Rujul-Rumale/INSPACe-CanSat-Team-Tejas-PCB-Design/README.md

# Tejas CanSat — Onboard Computer (OBC) PCB

Carrier board for our INSPACe CanSat ("Tejas") — Teensy 4.1, XBee radio, and a full
sensor suite (BNO055, BME688, DPS310, INA260, MICS5524) with dual buck regulators,
servo/ESC headers, and buzzer on a ~102×102 mm 2-layer board.

Designed by me (**Rujul Rumale**) in KiCad, Oct 2025 — schematic, layout, and Gerber
release. I also put together the data-processing section of our PFR deck.

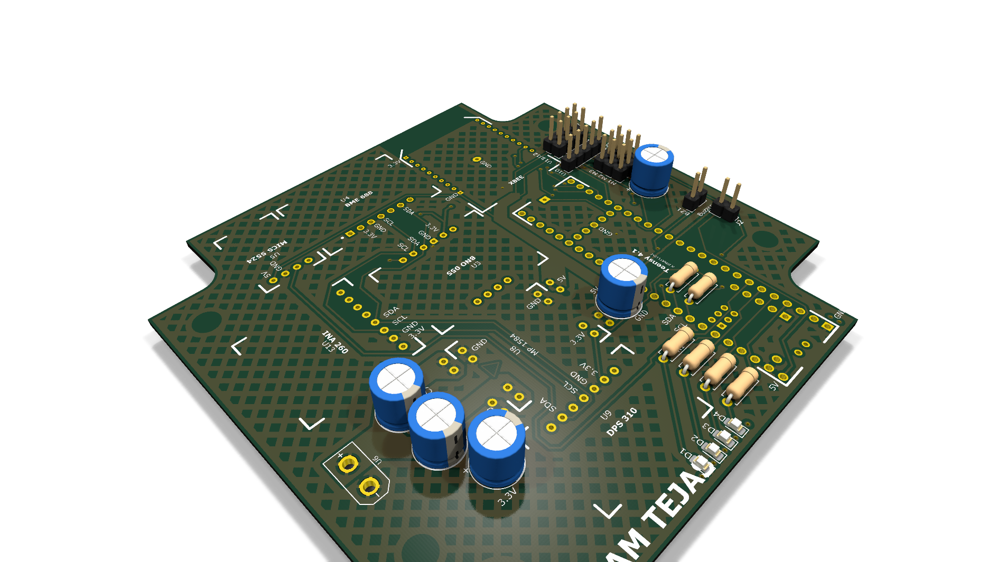
[picture p1: docs/renders/3d-iso.png]
3D isometric render


| Top | Bottom |
|---|---|
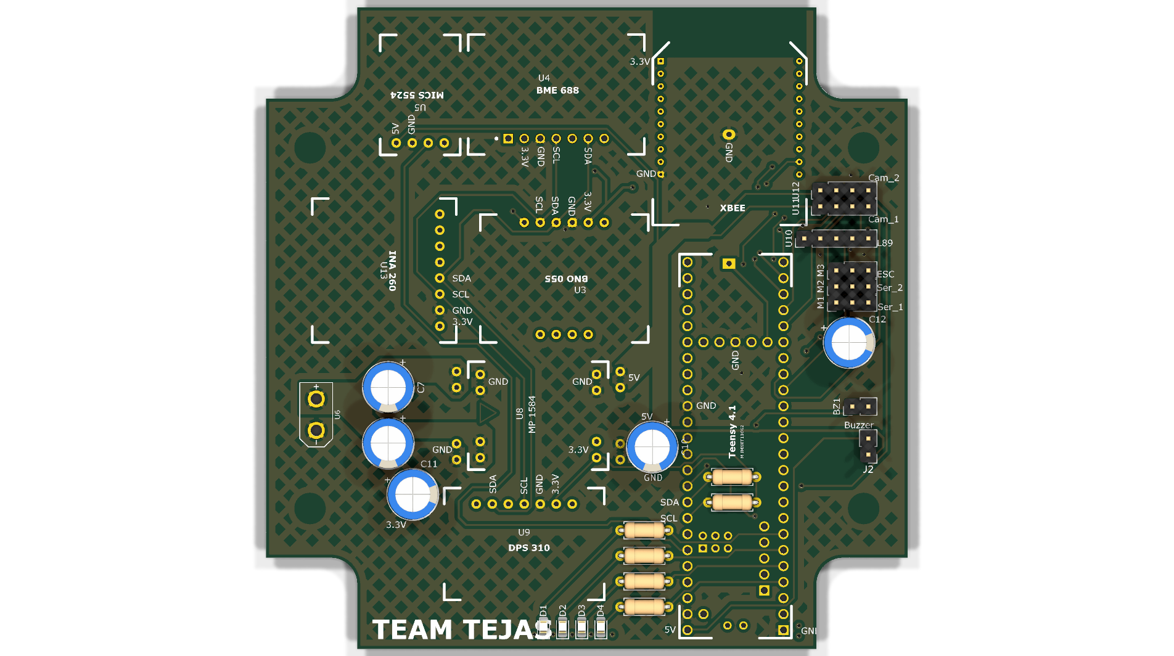
[picture p2: docs/renders/3d-top.png]
3D top
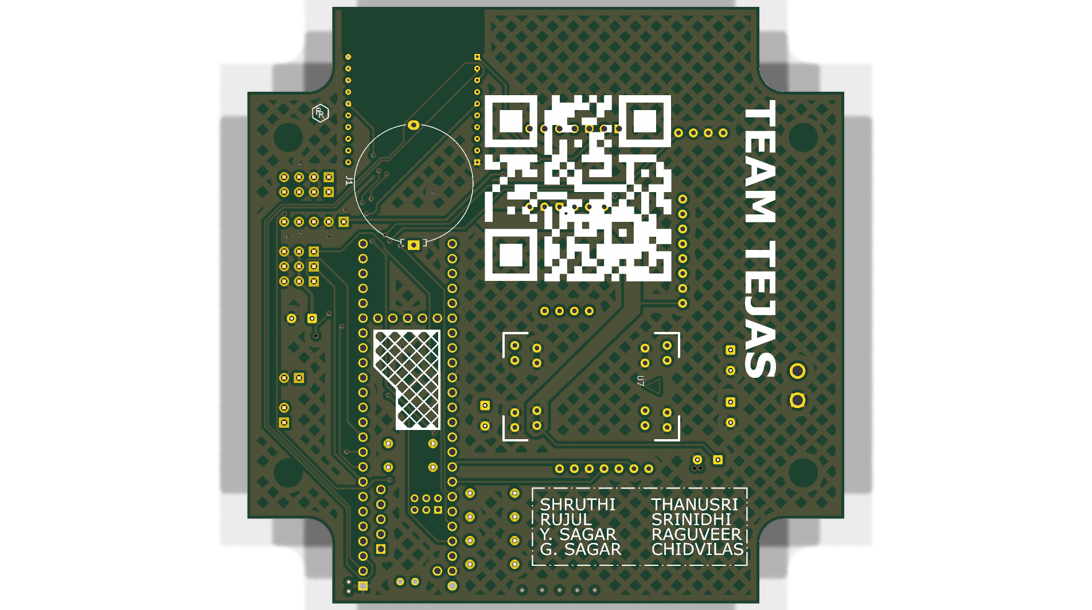
[picture p3: docs/renders/3d-bottom.png]
3D bottom
|  |  |

*Renders: KiCad raytracer. The custom module 3D bodies use absolute paths from my
old workstation, so modules show as footprints here — geometry and Gerbers are unaffected.*

## Photos — fabbed and assembled

The real thing: blue soldermask, fully populated and wired.

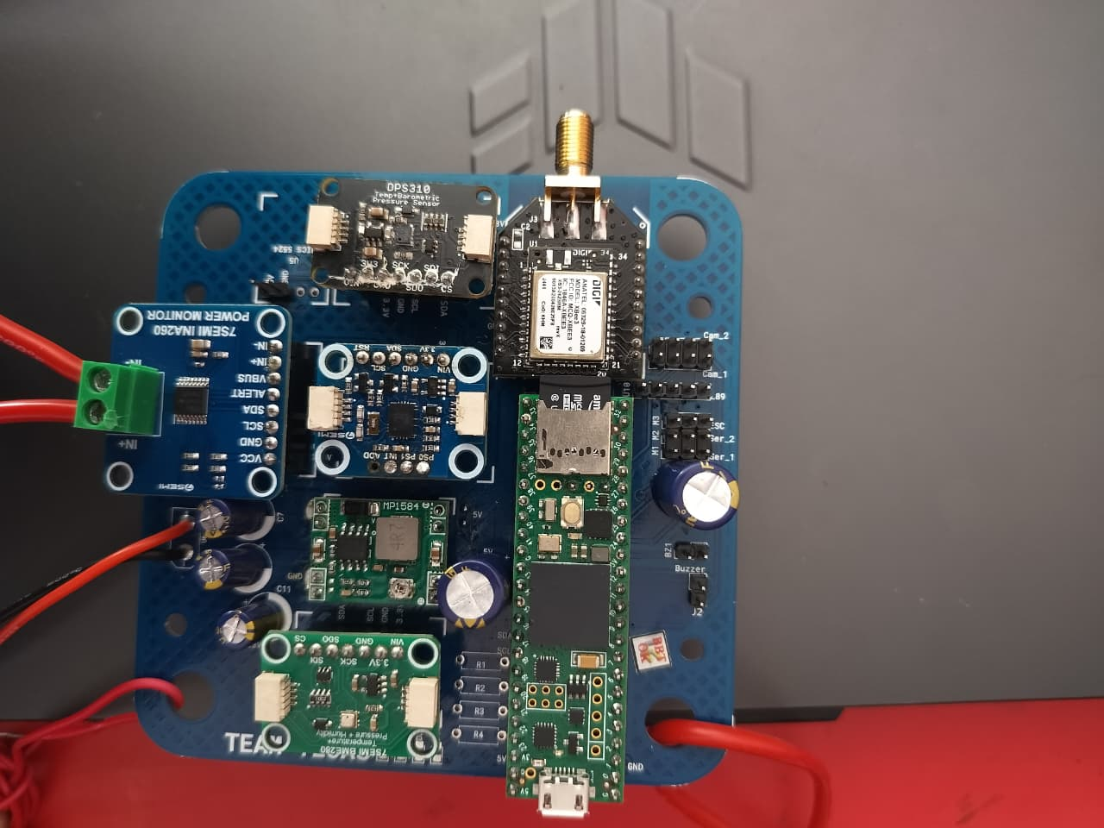
[picture p4: docs/photos/assembled-populated.jpeg]
Assembled board, populated and wired


| Bare fab — top | Bare fab — bottom |
|---|---|
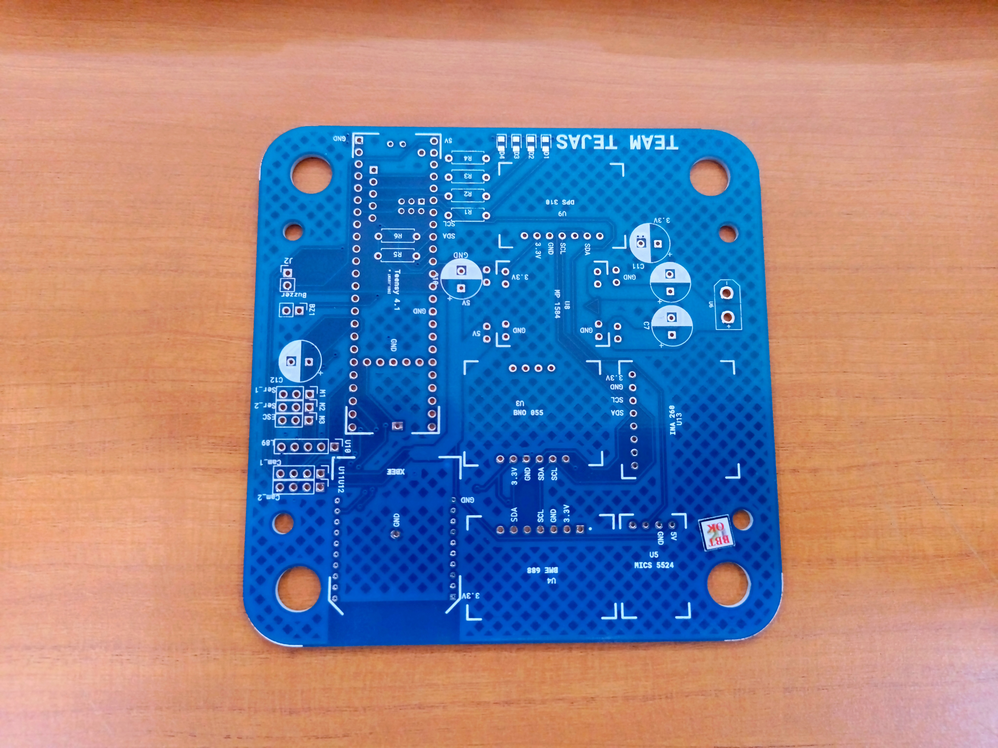
[picture p5: docs/photos/fab-top-bare.jpg]
Bare fab top
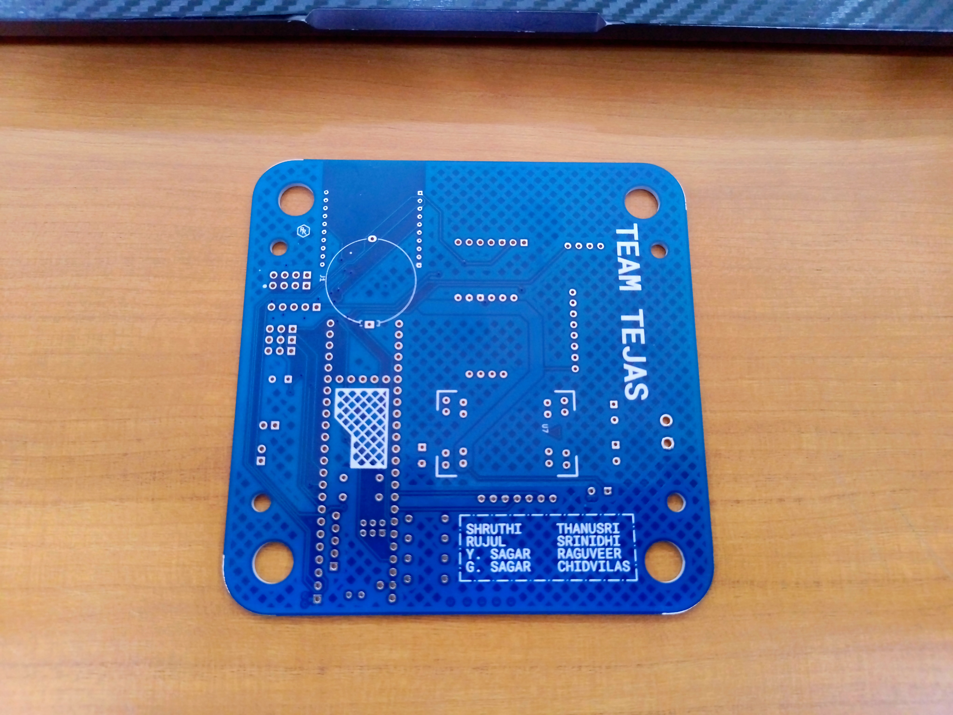
[picture p6: docs/photos/fab-bottom-bare.jpg]
Bare fab bottom
|  |  |

| 3D preview with modules — top | 3D preview with modules — bottom |
|---|---|
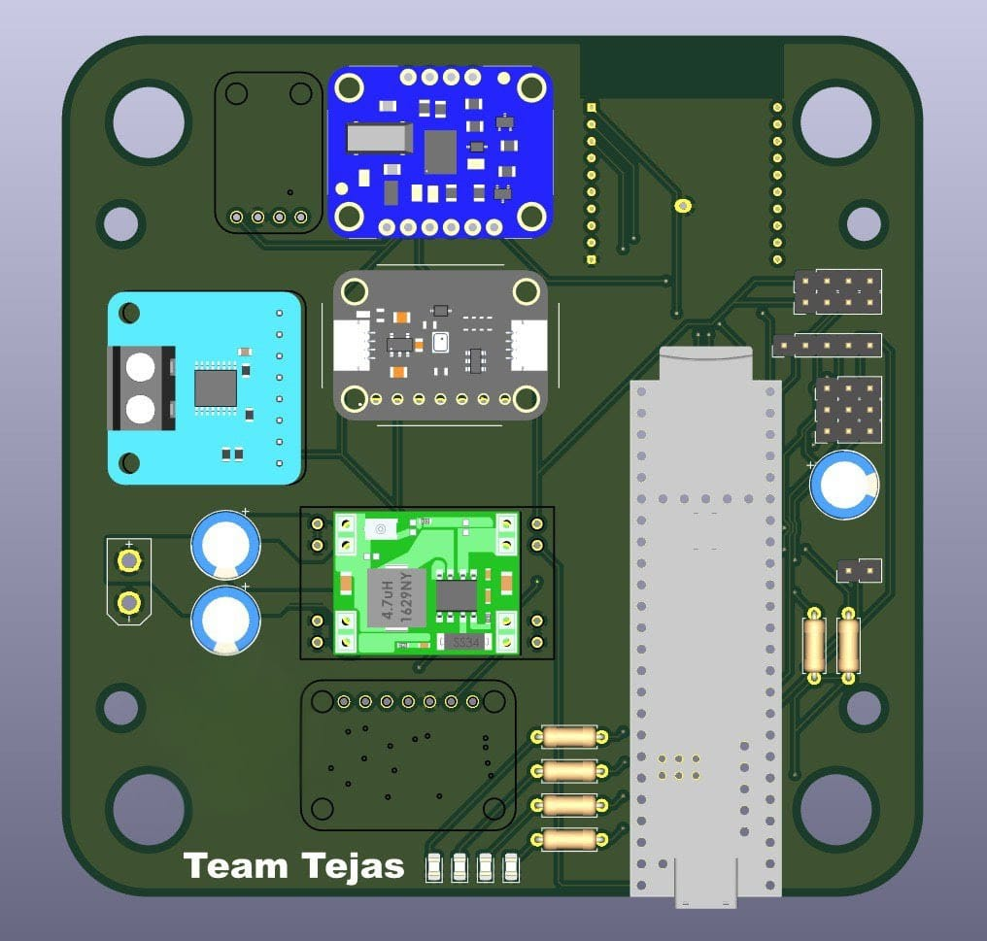
[picture p7: docs/photos/render-top-with-modules.jpeg]
3D top with modules
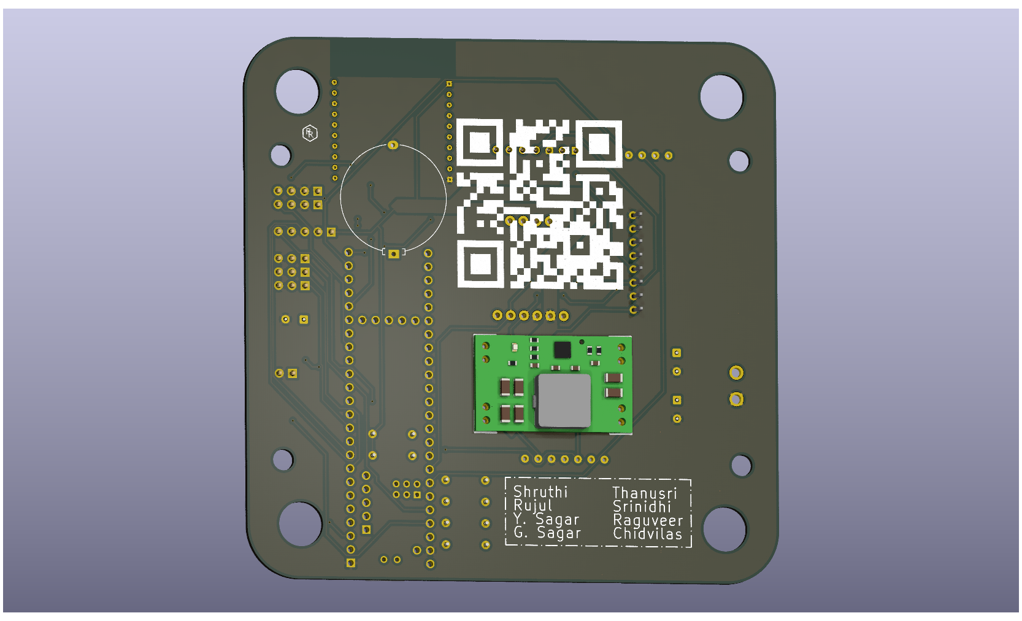
[picture p8: docs/photos/render-bottom-with-modules.png]
3D bottom with modules
|  |  |

## Board at a glance

- **Size:** 101.9 × 101.9 mm, 1.6 mm stackup, 2-layer (`docs/board-stats.rpt`)
- **Parts:** 41 BOM lines (`docs/bom.csv`) — Teensy 4.1, XBee, BNO055, BME280/BME688,
  MICS5524, DPS310, INA260, 2× buck (MINI560/MP1584), XT30, coin-cell retainer,
  servo/ESC headers
- **Copper:** 0.3 mm min track, 0.2 mm clearance, 38 vias, 199 pads
- **Fun detail:** the bottom silkscreen carries `TEAM TEJAS`, a QR code, and our
  team names — see `docs/renders/gerber-compare/v4-bottom.png`

## What's in here

| Path | What it is |
|---|---|
| `hardware/` | KiCad project — schematic (rev 2), layout, project settings. Opens in KiCad 9.0+ |
| `manufacturing/gerber-V4/` | The Gerber release we sent to fab (12 files, Oct 9) |
| `manufacturing/gerber-V3/` | Same design, plotted ~90 s earlier — kept for reference |
| `docs/renders/` | 3D PNGs, 2D front/back SVGs, schematic PDF, V3-vs-V4 Gerber comparisons |
| `docs/photos/` | Fab + assembly photos and module-fitted 3D previews |
| `docs/bom.csv` | Bill of materials, exported from the schematic |
| `docs/board-stats.rpt` | Layer / component / drill statistics |
| `docs/Tejas.pdf`, `docs/Tejas_Sch.pdf` | Board and schematic exports from the project |
| `libs/` | The symbol/footprint/3D libraries this board uses — see `libs/README.md` |
| `history/` | 25 KiCad auto-backup snapshots (Oct 4–18) plus the earliest Oct 3 schematic draft |
| `DESIGN_NOTES.md` | How the design evolved, and revision status |

## My work on this project

This was a team build. My contributions were the complete PCB — schematic,
footprints, layout, DRC, and the Gerber release — plus the data-processing
section of our PFR presentation. I also led the mechanical structure (3D
modeled in Autodesk Fusion with a teammate's help, 3D printed in ABS).
My teammates handled flight software, the ground-station GUI, MCP server,
and telemetry operations.

## Revision status

`manufacturing/gerber-V4/` is the release we flew. The working board file in
`hardware/` has a later board-outline experiment (stepped/notched edge, mounting
holes removed) that we decided not to go with — details in `DESIGN_NOTES.md`.
So if you want to build this, use the V4 Gerbers.

## Known issue → next rev

- **XBee mounting holes too small.** They're currently drawn at 0.5 mm drill
  (`libs/XB24CDMPIT-001/DIP-20.kicad_mod`) with no clearance tolerance, so the
  module/header wouldn't seat. Next revision needs these holes enlarged.
  Everything else on the fabbed board checked out.

## Reuse

Hardware is shared under the **CERN Open Hardware Licence v2 (Strongly
Reciprocal)** — see `LICENSE`. Docs/images are CC-BY-4.0.

SPDX: `SPDX-License-Identifier: CERN-OHL-S-2.0`

---

Views
