Rujul-Rumale/INSPACe-CanSat-Team-Tejas-PCB-Design/PROVENANCE.md

# Provenance — proof of authorship

**Designer:** Rujul Rumale <rujul.rumale@gmail.com>
**Artifact:** Tejas CanSat OBC PCB (INSPACe CanSat)
**Repo created:** 2026-10-10, curated from working folder `INSPACe_Can/tejas/`
**Source workstation path embedded in project:** `C:/Users/rujul/Downloads/Tejas_Gerber_V4/`
(`hardware/Tejas.kicad_pro`, `pcbnew.last_paths.plot`)

## SHA-256 (at time of curation)

| File | SHA-256 |
|---|---|
| `hardware/Tejas.kicad_pcb` | `34EB7ADCE4EB176BF5D209BD81BB5EEEB30C2339E8D29E24B8A98235EA0738BC` |
| `hardware/Tejas.kicad_pro` | `DBC62E33C33E39769E606A6D727C95B8F00AF4127BA4BDCD4596C21833E2D409` |
| `hardware/Tejas.kicad_sch` | `11DECA7BF7DDED36F694C0AE2E12FCA72740EB722455E79FDE70E15D2B176368` |
| `docs/Tejas.pdf` | `5ED2C2F5B795454C48E4ACE9A6849DAB436B2C551E78BEA5549AC84B3E83D411` |
| `docs/Tejas_Sch.pdf` | `716EFF7B3825487D1E6ABF25025DA3EF8526C9DDD39679D6CA9AD15F7A9C96B3` |

Verify any time with: `git hash-object hardware/Tejas.kicad_pcb` or `sha256sum`.
Note: opening the project in KiCad 10 rewrites `.kicad_pcb`/`.kicad_pro`
(format migration, no design change) — this repo pins the pristine Oct 2025
bytes above; `*.lck` and `.history/` are git-ignored for that reason.

## Design timeline (from KiCad auto-backups + file dates)

- 2025-10-03 12:44 → earliest standalone schematic `history/early-Tejas-2025-10-03.kicad_sch`
  (70 KB, recovered from workstation backup `D:/Backup/Open Source/KICAD Stuff/`)
- 2025-10-04 23:27 → first backup `Tejas-2025-10-04_232753.zip` (847,533 B)
- 2025-10-05 → 5 iterations (schematic capture phase)
- 2025-10-06 → 5 iterations incl. 2.1 MB layout `154121` (placement/routing)
- 2025-10-07 → schematic + layout refinement
- 2025-10-09 22:01/22:02 → Gerber releases V3 then V4 (final, 12 files each)
- 2025-10-11 → final PCB + project saves (`Tejas.kicad_pcb` 2025-10-11 14:02)
- 2026-02-14 → schematic PDF re-export for PFR deck

Full list of 25 zips is in `history/` with original timestamps preserved by this commit.

## Supporting evidence (outside this repo, same backup)

- `D:/Backup/Open Source/KICAD Stuff/` — original SnapEDA/Teensy/XBee/XT30
  libraries (copied into `libs/`), KiCad install copy
- `D:/Backup/Users/Downloads/07_Archives/Archives/Tejas.zip` (32 MB project archive),
  `Tejas_Gerber.zip`, `Tejas_Gerber_V4.zip`
- `D:/Backup/Users/Downloads/01_Documents/` — `Tejas_Components.docx`, `tejas_req.docx`,
  `TEJAS (AUSRC)-Invention Disclosre form.pdf`, `Tejas_PCB.pdf`, `TEJAS_PCB_V2.pdf`

## Approved release vs working file (2026-10-10 analysis)

- **Approved for fab:** `manufacturing/gerber-V4/` (2025-10-09 22:02). Matches the
  Oct 9 22:09 backup board state to 1 line; pixel-identical to V3.
- **Unapproved draft:** `hardware/Tejas.kicad_pcb` (Oct 11 working state) holds a
  board-outline rework made after the V4 plot that was never approved:
  Edge.Cuts redraw (8 mounting-hole circles deleted, stepped/notched outline),
  6 copper zones refilled as a consequence (~17 k lines, −51 KB).
  Footprints/tracks/vias/nets/schematic all untouched.
- Do not fab from `hardware/` without approval. Analysis method: backup-to-backup
  `.kicad_pcb` source diffs (same KiCad 9 format, zero tool noise) + footprint /
  track / zone-setting set comparison. (Direct KiCad-10 Gerber re-plots were
  rejected as evidence — this PC lacks the original `Roboto Mono` font, which
  alone shifts ~25 k silkscreen strokes.)

## Gerber V3 vs V4 verdict (2026-10-10)

All 12 files differ **only** in plot-timestamp comments
(`TF.CreationDate`, `G04 Created by KiCad (PCBNEW 9.0.3) date …`).
400 DPI raster renders (pygerber, Cu + silk + edge, top flipped-bottom)
are **pixel-identical** (difference extrema `(0, 0)` both sides).
V4 (2025-10-09 22:02:46–50) is the final release — matches `pcbnew.last_paths.plot`.
Comparisons: `docs/renders/gerber-compare/compare-top.png`, `compare-bottom.png`.

Physical attribution: bottom silkscreen etches `TEAM TEJAS`, a QR code, and the
team block `SHRUTHI / RUJUL / Y. SAGAR / G. SAGAR / THANUSRI / SRINIDHI /
RAGUVEER / CHIDVILAS` — visible in `v3-bottom.png` / `v4-bottom.png`.

## Renders

`docs/renders/` (KiCad 10, 2026-10-10): `3d-iso.png`, `3d-top.png`,
`3d-bottom.png` (raytraced, high), `pcb-front.svg` / `pcb-back.svg` (F/B Cu +
silk + mask), `schematic.pdf`. Generated from the pinned `hardware/` files.

## Contribution statement

I, Rujul Rumale, designed the Tejas CanSat PCB end-to-end: schematic (KiCad 9.0,
rev 2), component selection/footprints (incl. SnapEDA Adafruit 2472 BNO055 import),
layout, DRC, and Gerber V3/V4 manufacturing release. I also authored the
data-processing portion of the PFR presentation. Flight software, GUI, MCP server,
and telemetry operations are the work of teammates and are NOT claimed here.

Signed: Rujul Rumale, 2026-10-10.
