Rujul-Rumale/INSPACe-CanSat-Team-Tejas-PCB-Design/docs/renders/gerber-compare/compare-bottom.png

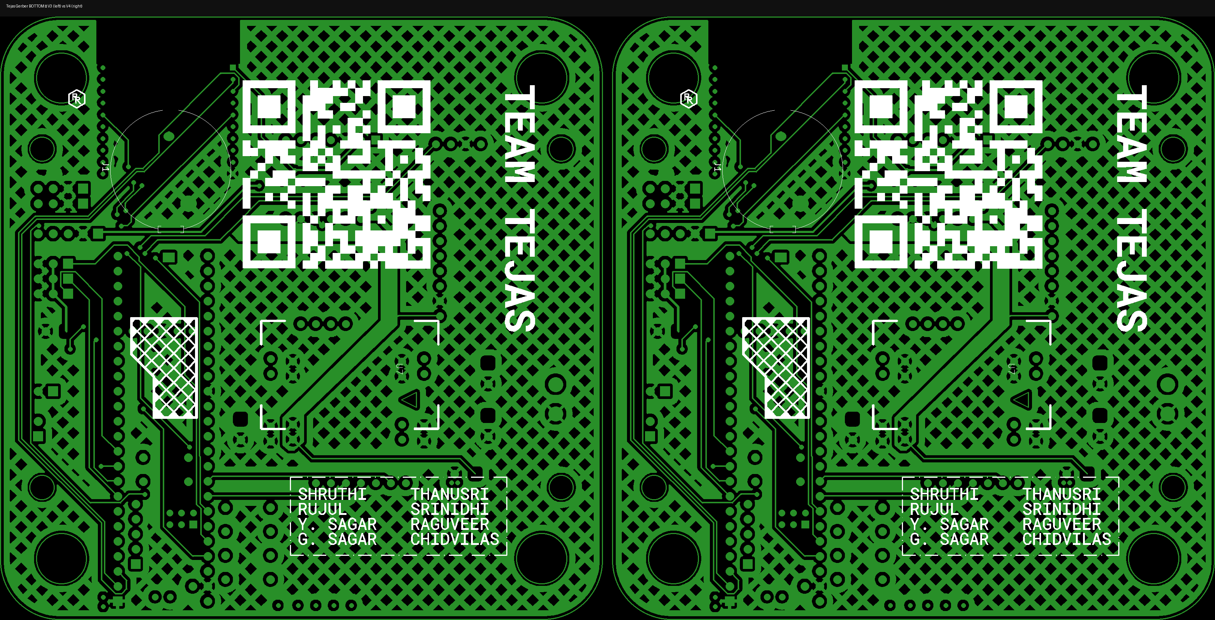
docs/renders/gerber-compare/compare-bottom.png
