Rujul-Rumale/INSPACe-CanSat-Team-Tejas-PCB-Design/docs/renders/gerber-compare/compare-top.png

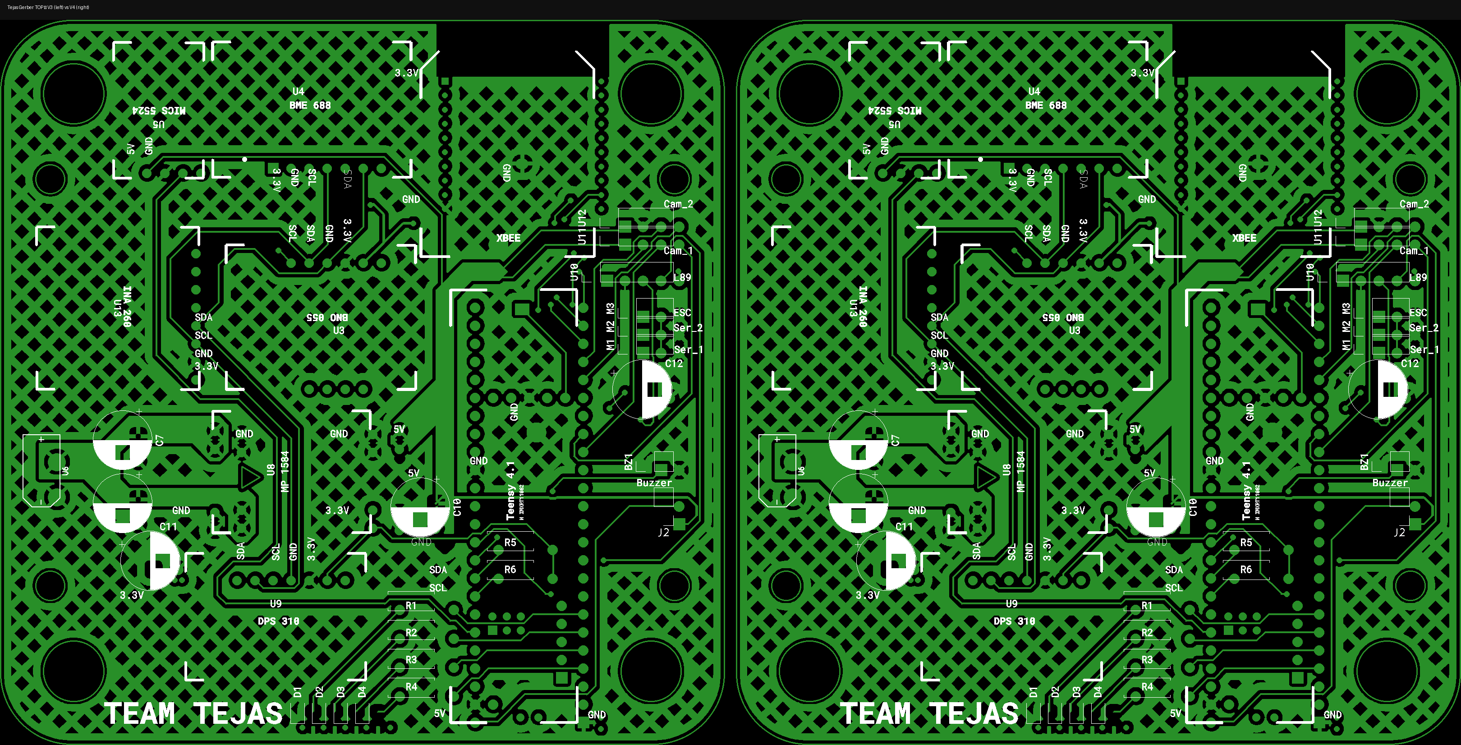
docs/renders/gerber-compare/compare-top.png
