Rujul-Rumale/INSPACe-CanSat-Team-Tejas-PCB-Design/docs/renders/gerber-compare/v3-top.png

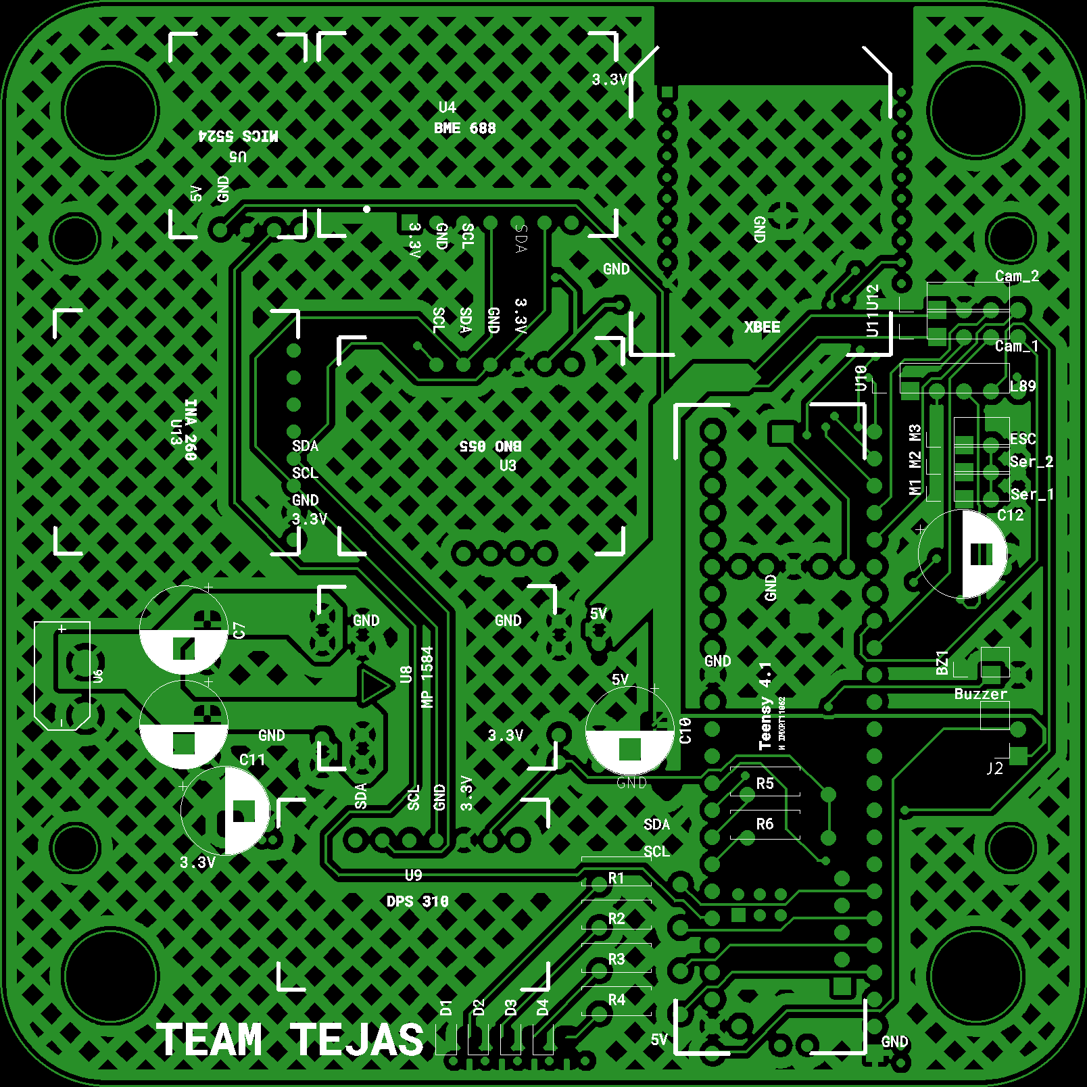
docs/renders/gerber-compare/v3-top.png
