Rujul-Rumale/INSPACe-CanSat-Team-Tejas-PCB-Design/docs/bom.csv

Refs | Value | Footprint | Qty | DNP
BZ1 | Buzzer | Connector_PinHeader_2.54mm:PinHeader_1x02_P2.54mm_Vertical | 1
C1 | C_Polarized |  | 1
C2 | C_Polarized |  | 1
C3 | C_Polarized |  | 1
C4 | C_Polarized |  | 1
C5 | C_Polarized |  | 1
C6 | C_Polarized |  | 1
C7 | C_Polarized | Capacitor_THT:CP_Radial_D8.0mm_P3.50mm | 1
C8 | C_Polarized |  | 1
C9 | C_Polarized | Capacitor_THT:CP_Radial_D8.0mm_P3.50mm | 1
C10 | C_Polarized | Capacitor_THT:CP_Radial_D8.0mm_P3.50mm | 1
C11 | C_Polarized | Capacitor_THT:CP_Radial_D8.0mm_P3.50mm | 1
C12 | C_Polarized | Capacitor_THT:CP_Radial_D8.0mm_P3.50mm | 1
D1 | LED | LED_SMD:LED_0805_2012Metric_Pad1.15x1.40mm_HandSolder | 1
D2 | LED | LED_SMD:LED_0805_2012Metric_Pad1.15x1.40mm_HandSolder | 1
D3 | LED | LED_SMD:LED_0805_2012Metric_Pad1.15x1.40mm_HandSolder | 1
D4 | LED | LED_SMD:LED_0805_2012Metric_Pad1.15x1.40mm_HandSolder | 1
J1 | S8421-45R | Battery:Battery_Panasonic_CR2032-HFN_Horizontal_CircularHoles | 1
J2 | Conn_01x02_Pin | Connector_PinHeader_2.54mm:PinHeader_1x02_P2.54mm_Vertical | 1
M1 | Motor_Servo | Connector_PinHeader_2.54mm:PinHeader_1x03_P2.54mm_Vertical | 1
M2 | Motor_Servo | Connector_PinHeader_2.54mm:PinHeader_1x03_P2.54mm_Vertical | 1
M3 | Motor_Servo | Connector_PinHeader_2.54mm:PinHeader_1x03_P2.54mm_Vertical | 1
R1 | R | Resistor_THT:R_Axial_DIN0207_L6.3mm_D2.5mm_P7.62mm_Horizontal | 1
R2 | R | Resistor_THT:R_Axial_DIN0207_L6.3mm_D2.5mm_P7.62mm_Horizontal | 1
R3 | R | Resistor_THT:R_Axial_DIN0207_L6.3mm_D2.5mm_P7.62mm_Horizontal | 1
R4 | R | Resistor_THT:R_Axial_DIN0207_L6.3mm_D2.5mm_P7.62mm_Horizontal | 1
R5 | R | Resistor_THT:R_Axial_DIN0207_L6.3mm_D2.5mm_P7.62mm_Horizontal | 1
R6 | R | Resistor_THT:R_Axial_DIN0207_L6.3mm_D2.5mm_P7.62mm_Horizontal | 1
U1 | Teensy4.1 | teensy_library-master:Teensy41 | 1
U2 | XB24-ASI-001 | XB24CDMPIT-001:DIP-20 | 1
U3 | BNO055 | 2472:MODULE_2472 | 1
U4 | BME280 | 2652:MODULE_2652 | 1
U5 | MICS_5524 | 2472:MICS 5524 | 1
U6 | XT30UPB-M | Open Source:XT30UPB-M | 1
U7 | BUCK_5A | 2472:MINI560 | 1
U8 | BUCK_5A | 2472:MP1284 | 1
U9 | DPS310 | 2472:DPS 310 | 1
U10 | L89 | Connector_PinHeader_2.54mm:PinHeader_1x05_P2.54mm_Vertical | 1
U11 | ESP | Connector_PinHeader_2.54mm:PinHeader_1x04_P2.54mm_Vertical | 1
U12 | ESP | Connector_PinHeader_2.54mm:PinHeader_1x04_P2.54mm_Vertical | 1
U13 | INA260 | 2472:INA_260 | 1
