Rujul-Rumale/INSPACe-CanSat-Team-Tejas-PCB-Design/docs/renders/schematic.pdf

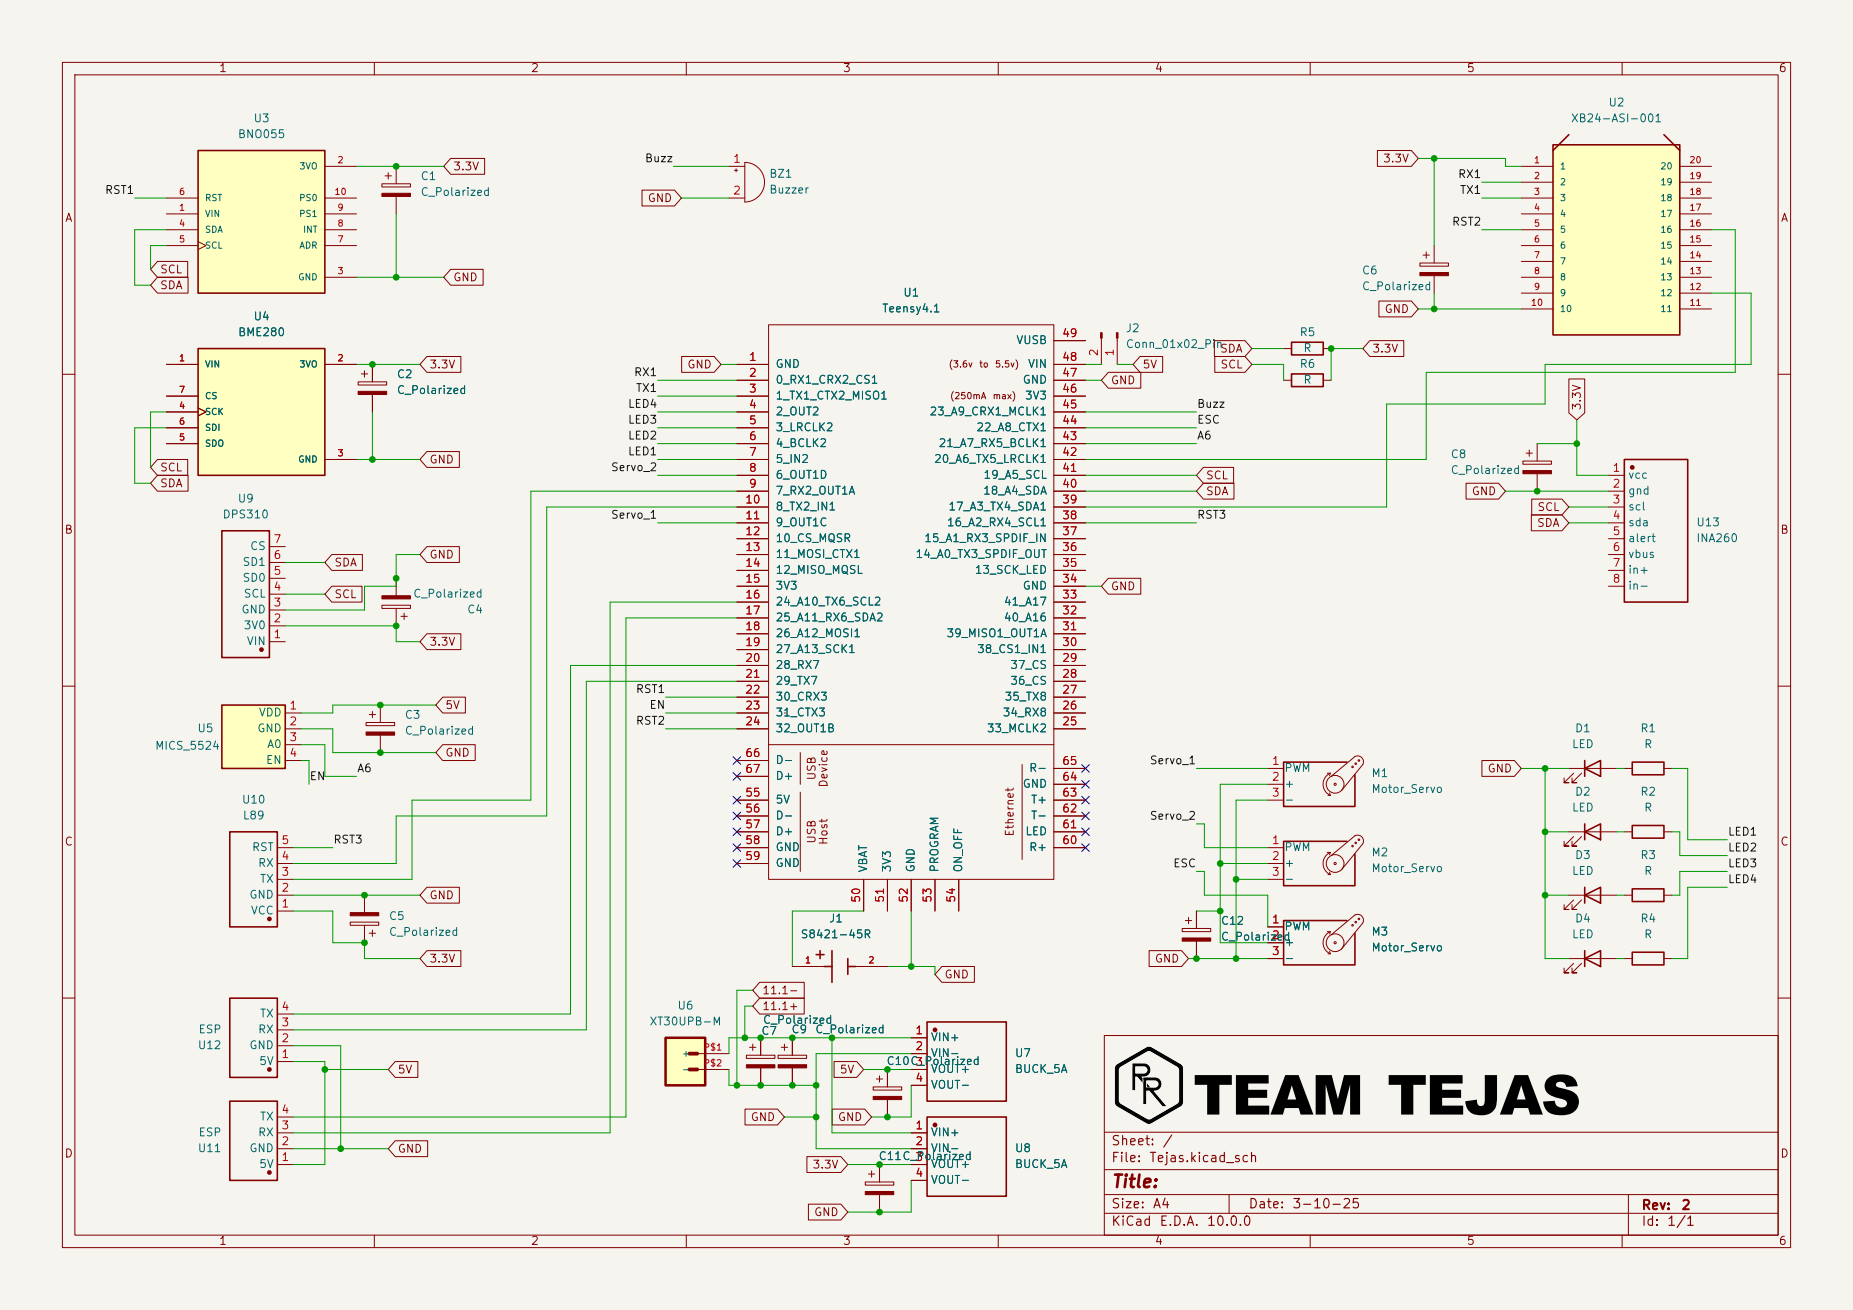
[picture p13: page 1]

29_TX7 21
30_CRX3 22

LED USB USB Device Host

Size: A4 | Rev: 2
