Rujul-Rumale/INSPACe-CanSat-Team-Tejas-PCB-Design/docs/Tejas.pdf

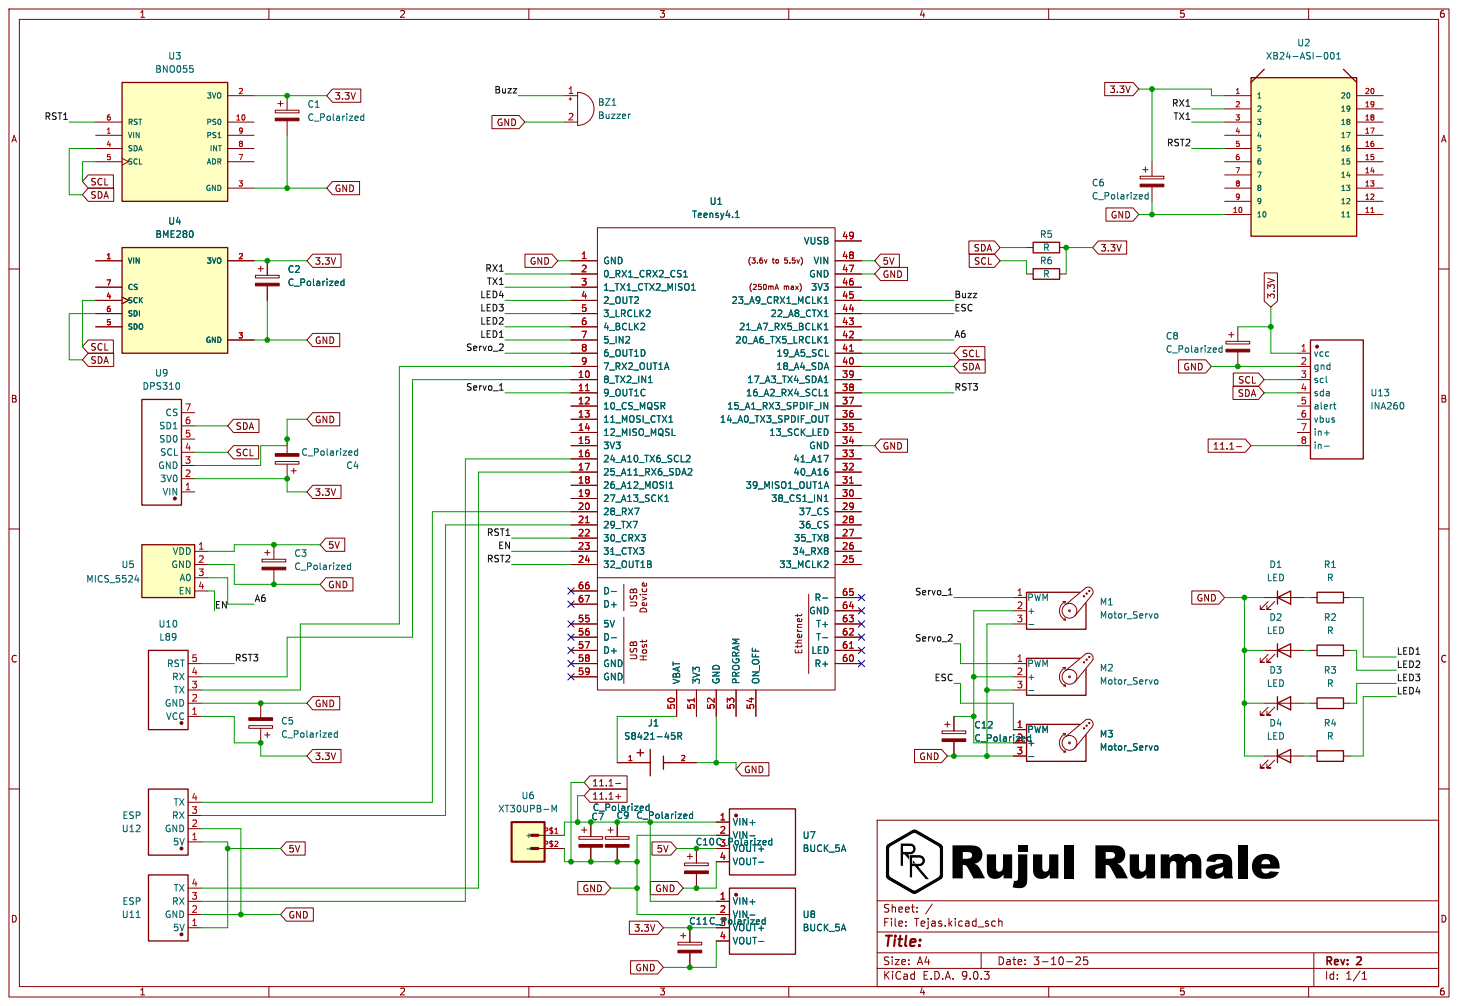
[picture p14: page 1]

5V 1 GND 2 RX 3 TX 4 U12 ESP
