Rujul-Rumale/INSPACe-CanSat-Team-Tejas-PCB-Design/docs/Tejas_Sch.pdf

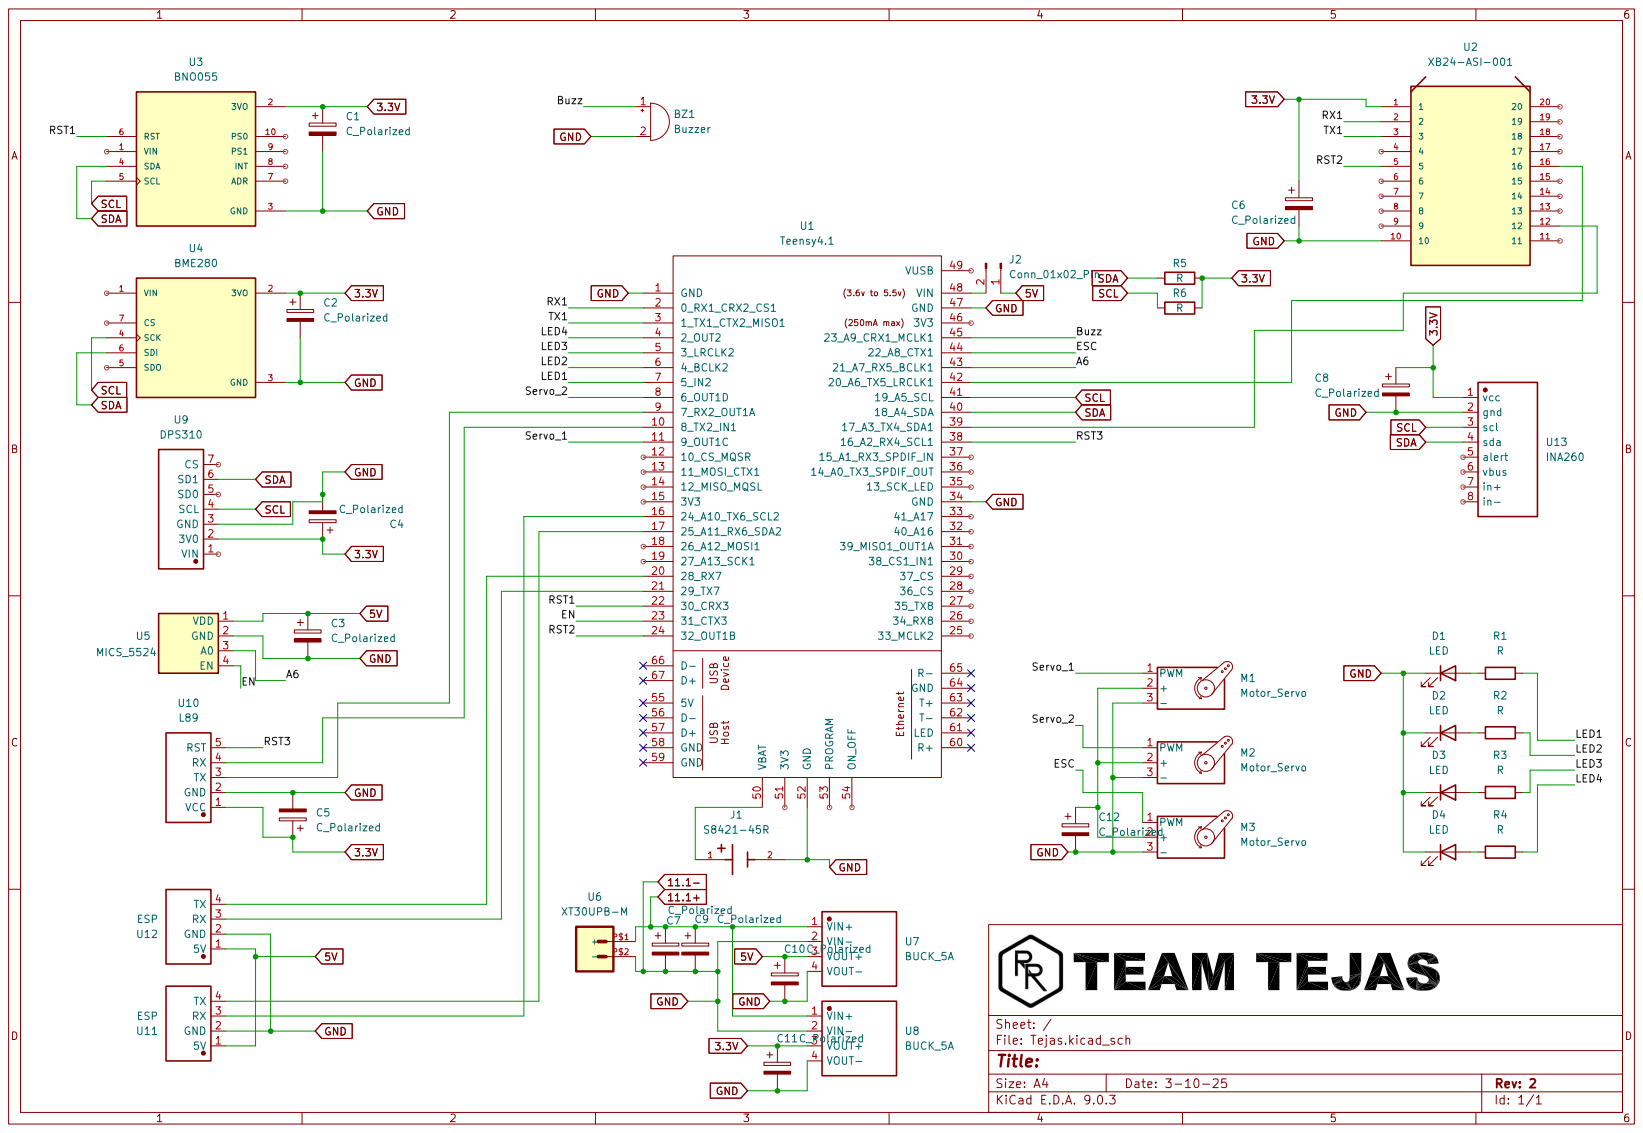
[picture p15: page 1]
