Rujul-Rumale/INSPACe-CanSat-Team-Tejas-PCB-Design/hardware/Tejas.kicad_pcb

## KiCad design hardware/Tejas.kicad_pcb (2026-10-10)

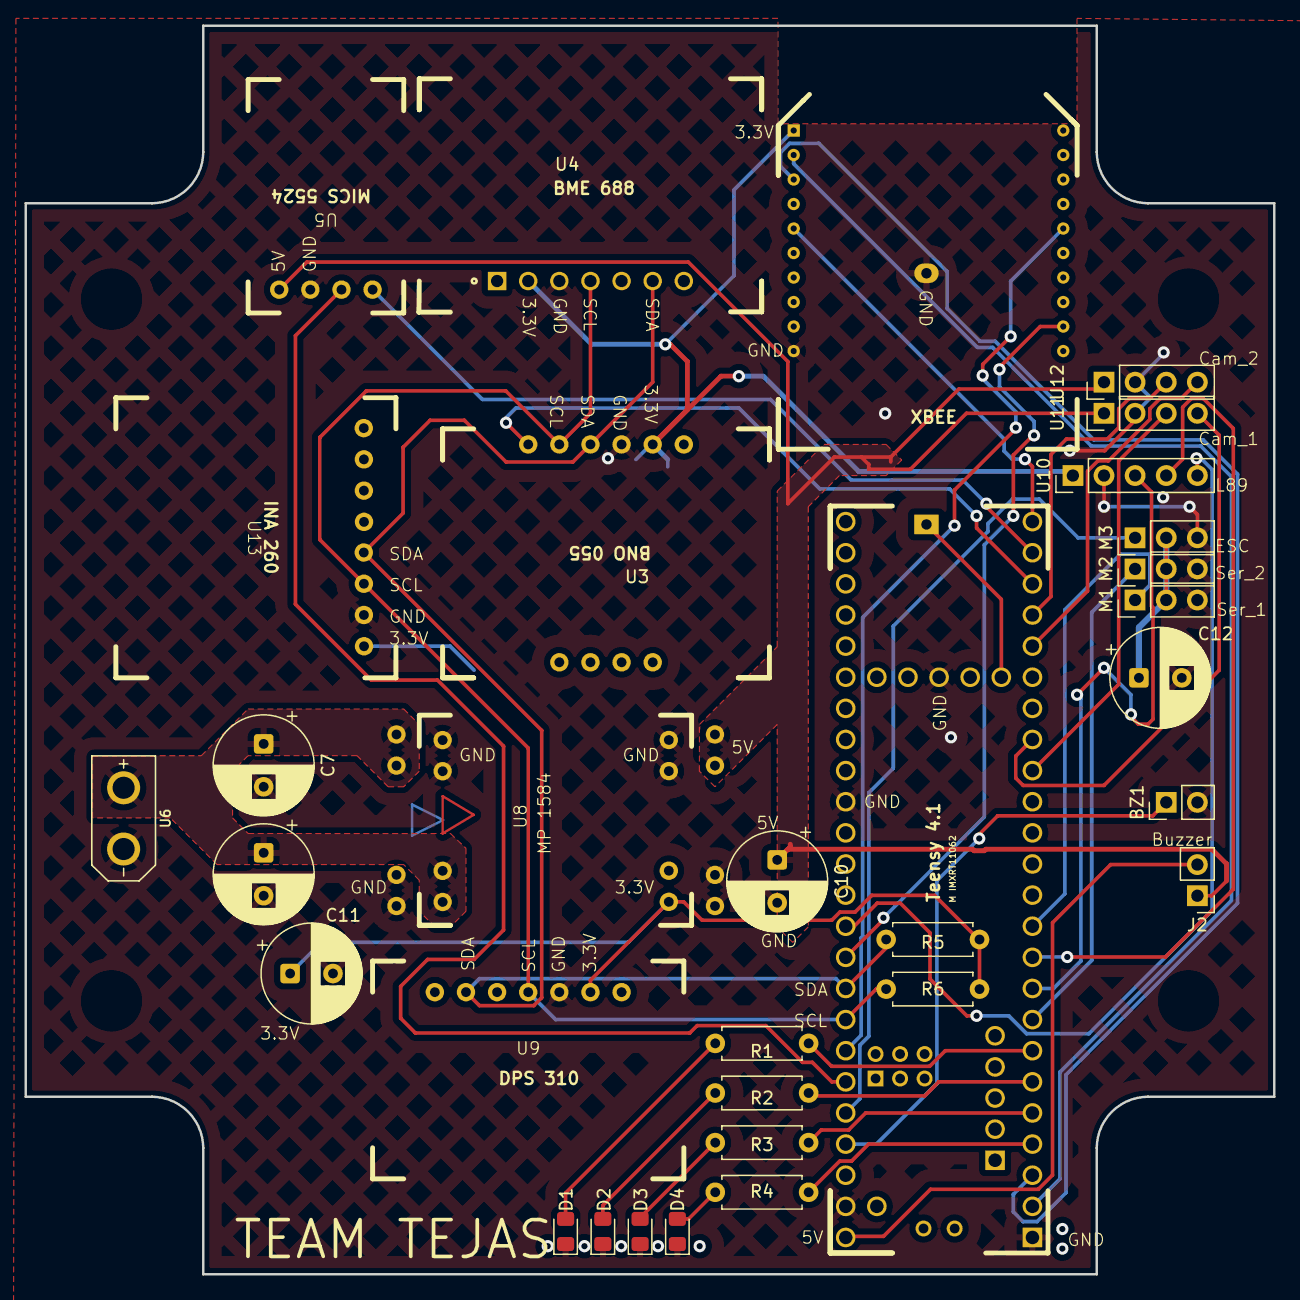
[picture p16: board Tejas.kicad_pcb from above]

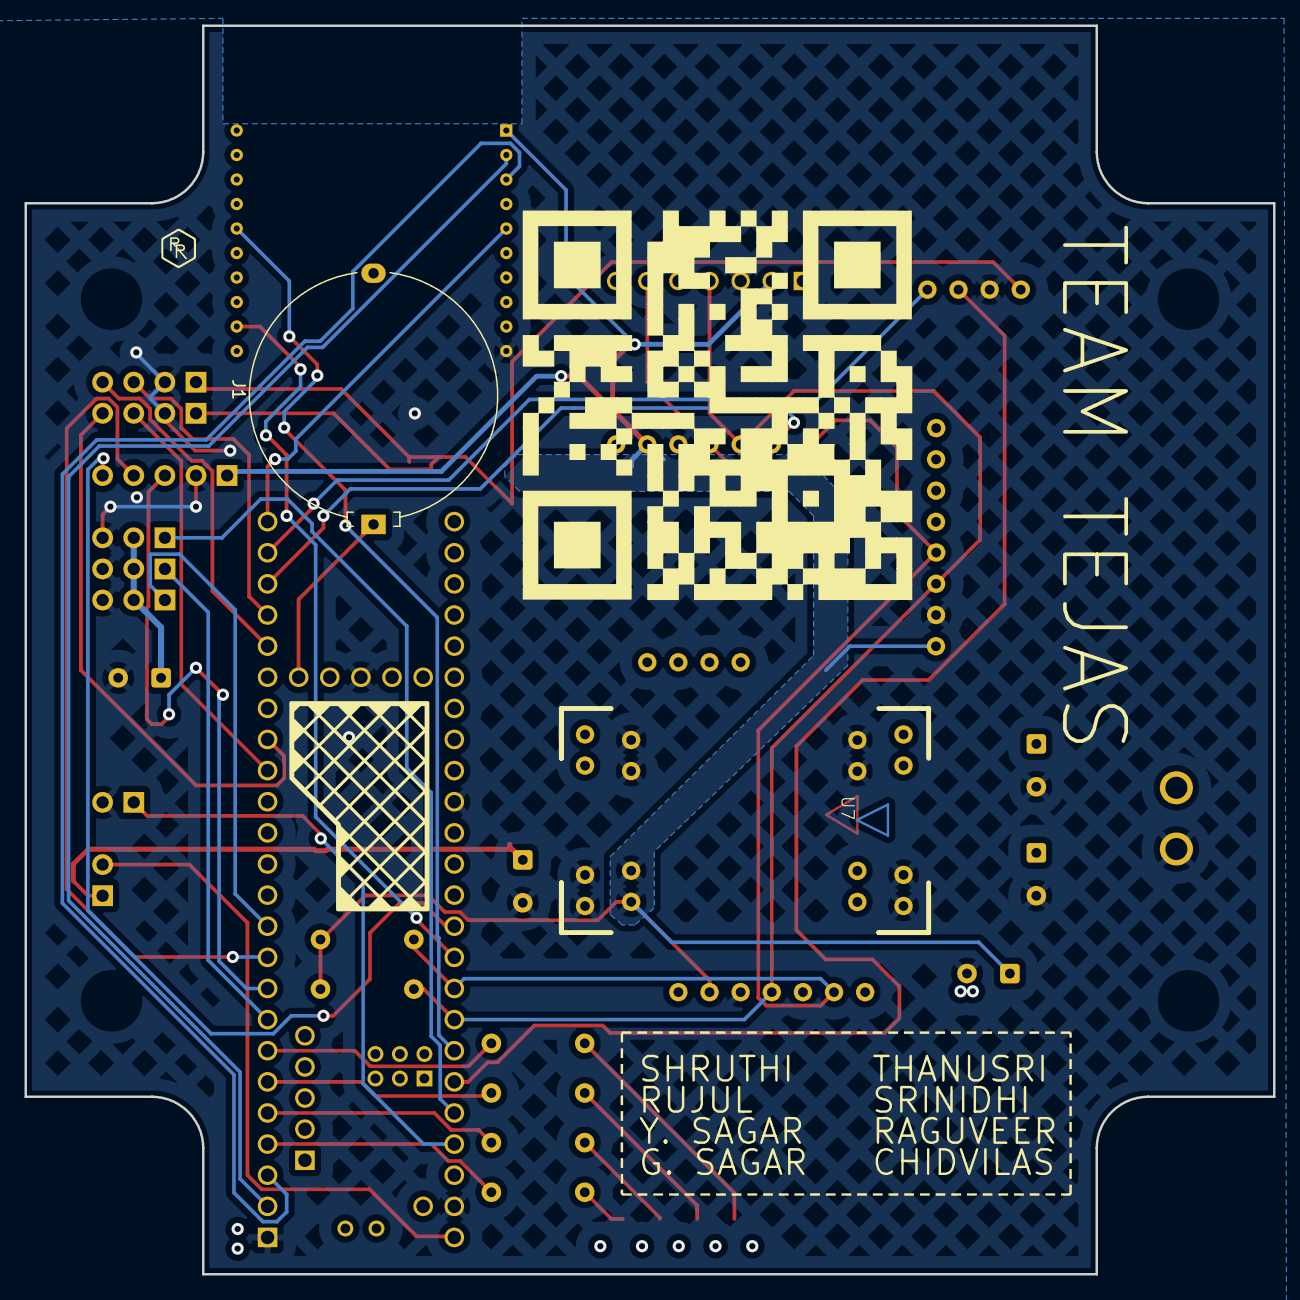
[picture p17: board Tejas.kicad_pcb from below]

Board: 2 copper layers, 101.9 x 101.9 mm, 34 parts (2 on the bottom side), 36 nets.

Parts:
BZ1: Buzzer; PinHeader_1x02_P2.54mm_Vertical
C7, C9, C10, C11, C12: C_Polarized; CP_Radial_D8.0mm_P3.50mm
D1, D2, D3, D4: LED; LED_0805_2012Metric_Pad1.15x1.40mm_HandSolder
J1: S8421-45R; Battery_Panasonic_CR2032-HFN_Horizontal_CircularHoles
J2: Conn_01x02_Pin; PinHeader_1x02_P2.54mm_Vertical
M1, M2, M3: Motor_Servo; PinHeader_1x03_P2.54mm_Vertical
R1, R2, R3, R4, R5, R6: R; R_Axial_DIN0207_L6.3mm_D2.5mm_P7.62mm_Horizontal
U1: Teensy4.1; Teensy41
U2: XB24-ASI-001; DIP-20
U3: BNO055; MODULE_2472
U4: BME280; MODULE_2652
U5: MICS_5524; MICS 5524
U6: XT30UPB-M
U7: BUCK_5A; MINI560
U8: BUCK_5A; MP1284
U9: DPS310; DPS 310
U10: L89; PinHeader_1x05_P2.54mm_Vertical
U11, U12: ESP; PinHeader_1x04_P2.54mm_Vertical
U13: INA260; INA_260

Connections:
3.3V: C11.1, R5.2, R6.2, U2.1, U3.2 (3VO), U4.2 (3VO), U8.3 (VOUT+), U9.2 (3V0), U10.1 (VCC), U13.1 (vcc)
5V: C10.1, J2.1, U5.1 (VDD), U7.3 (VOUT+), U11.1 (5V), U12.1 (5V)
11.1+: C7.1, C9.1, U6.P$1 (+), U7.1 (VIN+), U8.1 (VIN+)
11.1-: BZ1.2 (-), C7.2, C9.2, C10.2, C11.2, C12.2, D1.1 (K), D2.1 (K), D3.1 (K), D4.1 (K), J1.2, M1.3 (-), M2.3 (-), M3.3 (-), U1.1 (GND), U1.34 (GND), U1.47 (GND), U1.52 (GND), U2.10, U3.3 (GND), U4.3 (GND), U5.2 (GND), U6.P$2 (-), U7.2 (VIN-), U7.4 (VOUT-), U8.2 (VIN-), U8.4 (VOUT-), U9.3 (GND), U10.2 (GND), U11.2 (GND), U12.2 (GND), U13.2 (gnd)
/A6: U1.43 (21_A7_RX5_BCLK1), U5.3 (A0)
/Buzz: BZ1.1 (+), U1.45 (23_A9_CRX1_MCLK1)
/EN: U1.23 (31_CTX3), U5.4 (EN)
/ESC: M3.1 (PWM), U1.44 (22_A8_CTX1)
/LED1: R1.2, U1.7 (5_IN2)
/LED2: R2.2, U1.6 (4_BCLK2)
/LED3: R3.2, U1.5 (3_LRCLK2)
/LED4: R4.2, U1.4 (2_OUT2)
/RST1: U1.22 (30_CRX3), U3.6 (RST)
/RST2: U1.24 (32_OUT1B), U2.5
/RST3: U1.38 (16_A2_RX4_SCL1), U10.5 (RST)
/RX1: U1.2 (0_RX1_CRX2_CS1), U2.2
/Servo_1: M1.1 (PWM), U1.11 (9_OUT1C)
/Servo_2: M2.1 (PWM), U1.8 (6_OUT1D)
/TX1: U1.3 (1_TX1_CTX2_MISO1), U2.3
unnamed: D1.2 (A), R1.1
unnamed: D2.2 (A), R2.1
unnamed: D3.2 (A), R3.1
unnamed: D4.2 (A), R4.1
unnamed: J2.2, U1.48 (VIN)
unnamed: C12.1, M1.2 (+), M2.2 (+), M3.2 (+)
unnamed: U1.9 (7_RX2_OUT1A), U10.3 (TX)
unnamed: U1.10 (8_TX2_IN1), U10.4 (RX)
unnamed: U1.39 (17_A3_TX4_SDA1), U2.12
unnamed: U1.42 (20_A6_TX5_LRCLK1), U2.16
unnamed: U1.16 (24_A10_TX6_SCL2), U11.3 (RX)
unnamed: U1.17 (25_A11_RX6_SDA2), U11.4 (TX)
unnamed: U1.20 (28_RX7), U12.4 (TX)
unnamed: U1.21 (29_TX7), U12.3 (RX)
unnamed: J1.1, U1.50 (VBAT)
SCL: R6.1, U1.41 (19_A5_SCL), U3.5 (SCL), U4.4 (SCK), U9.4 (SCL), U13.3 (scl)
SDA: R5.1, U1.40 (18_A4_SDA), U3.4 (SDA), U4.6 (SDI), U9.6 (SD1), U13.4 (sda)
