Rujul-Rumale/INSPACe-CanSat-Team-Tejas-PCB-Design/(commit log)

2026-10-10 Tejas CanSat OBC PCB by Rujul Rumale: schematic + layout + Gerber V3/V4 + 25 design-history backups
    Author: Rujul Rumale <rujul.rumale@gmail.com>
    Scope: full PCB (schematic capture, layout, DRC, Gerber release Oct 2025)
    plus PFR PPT data-processing section (slides in team deck, not here).
    Hardware license: CERN-OHL-S-2.0. Docs: CC-BY-4.0.
2026-10-10 Gather all .pretty/.kicad_mod/.kicad_sym/.step libraries into libs/ (one place)
    Sources: OneDrive KiCad_Libraries (GY-521, HC-12, ESP32-C3-SuperMini,
    MP1584, ZC323200, msalamon) - 27 lib files. Tejas SnapEDA .pretty
    sources (2472/2652/teensy/XBee/XT30) documented as missing in
    libs/README (were on original C:/Open Source workstation).
2026-10-10 Renders + original libs + early schematic; restore pristine .pro
    - docs/renders: 3D top/bottom/iso PNGs (KiCad 10 raytrace), 2D
    front/back SVGs, schematic PDF; docs/bom.csv (41 lines),
    docs/board-stats.rpt (101.9x101.9mm, 34 footprints, 38 vias)
    - libs: original Tejas sources recovered from workstation backup
    (2472/2652/teensy/XBee/S8421-45R/XT30UPB-M/Sensors) + README
    - history: earliest schematic 2025-10-03 (70KB draft)
    - restore pristine Tejas.kicad_pro (revert KiCad 10 auto-migration);
    .gitignore *.lck + .history/; README/PROVENANCE updated
2026-10-10 Gerber V3 vs V4: renders + identical verdict (V4 final)
    - docs/renders/gerber-compare: v3/v4 top+bottom PNGs (pygerber,
    400dpi Cu+silk+edge) + side-by-side compare images
    - Verdict: only timestamp comments differ; pixel diff exactly
    zero both sides. V4 (plotted ~90s later, matches project plot
    path) is the fab release.
    - README/PROVENANCE: verdict + bottom-silk team credits
    (TEAM TEJAS / RUJUL etched on board)
2026-10-10 Mark V4 approved; document unapproved outline change in working file
    - hardware/Tejas.kicad_pcb (Oct 11) vs Oct 9 22:09 backup: Edge.Cuts
    rework only (8 mounting holes removed, stepped/notched outline,
    zones refilled). Footprints/tracks/vias/nets/schematic untouched.
    - manufacturing/gerber-V4 confirmed as approved fab release
    (matches backup state to 1 line; pixel-identical to V3).
    - Restore pristine .kicad_pro (KiCad 10 rewrites it on open).
2026-10-10 Present repo as project showcase, not authorship file
    - README rewritten: what the board is, specs, renders, my role
    - PROVENANCE.md -> DESIGN_NOTES.md (evolution, V3/V4, outline note)
    - Drop AUTHORS (covered in README); soften libs/README
2026-10-10 README: reword team section, add XBee mounting-hole errata
2026-10-10 README: credit structure work alongside PCB
2026-10-10 Revert structure additions — deferred for now
2026-10-10 README: mention structure work (Fusion, ABS print); files to follow
2026-10-10 Add fab + assembly photos and module-fitted 3D previews
2026-10-20 docs: switch view counter to hits.sh (GitHub-friendly)
